dgarigali/SmartOfficeIllumination/(commit log)

2019-09-13 Added arduino folder
2019-09-14 Added raspberry pi folder
